kbball/runner-early-warning/hardware/ew-carrier/ew-carrier.kicad_sch

## KiCad design hardware/ew-carrier/ew-carrier.kicad_sch (2026-10-12)

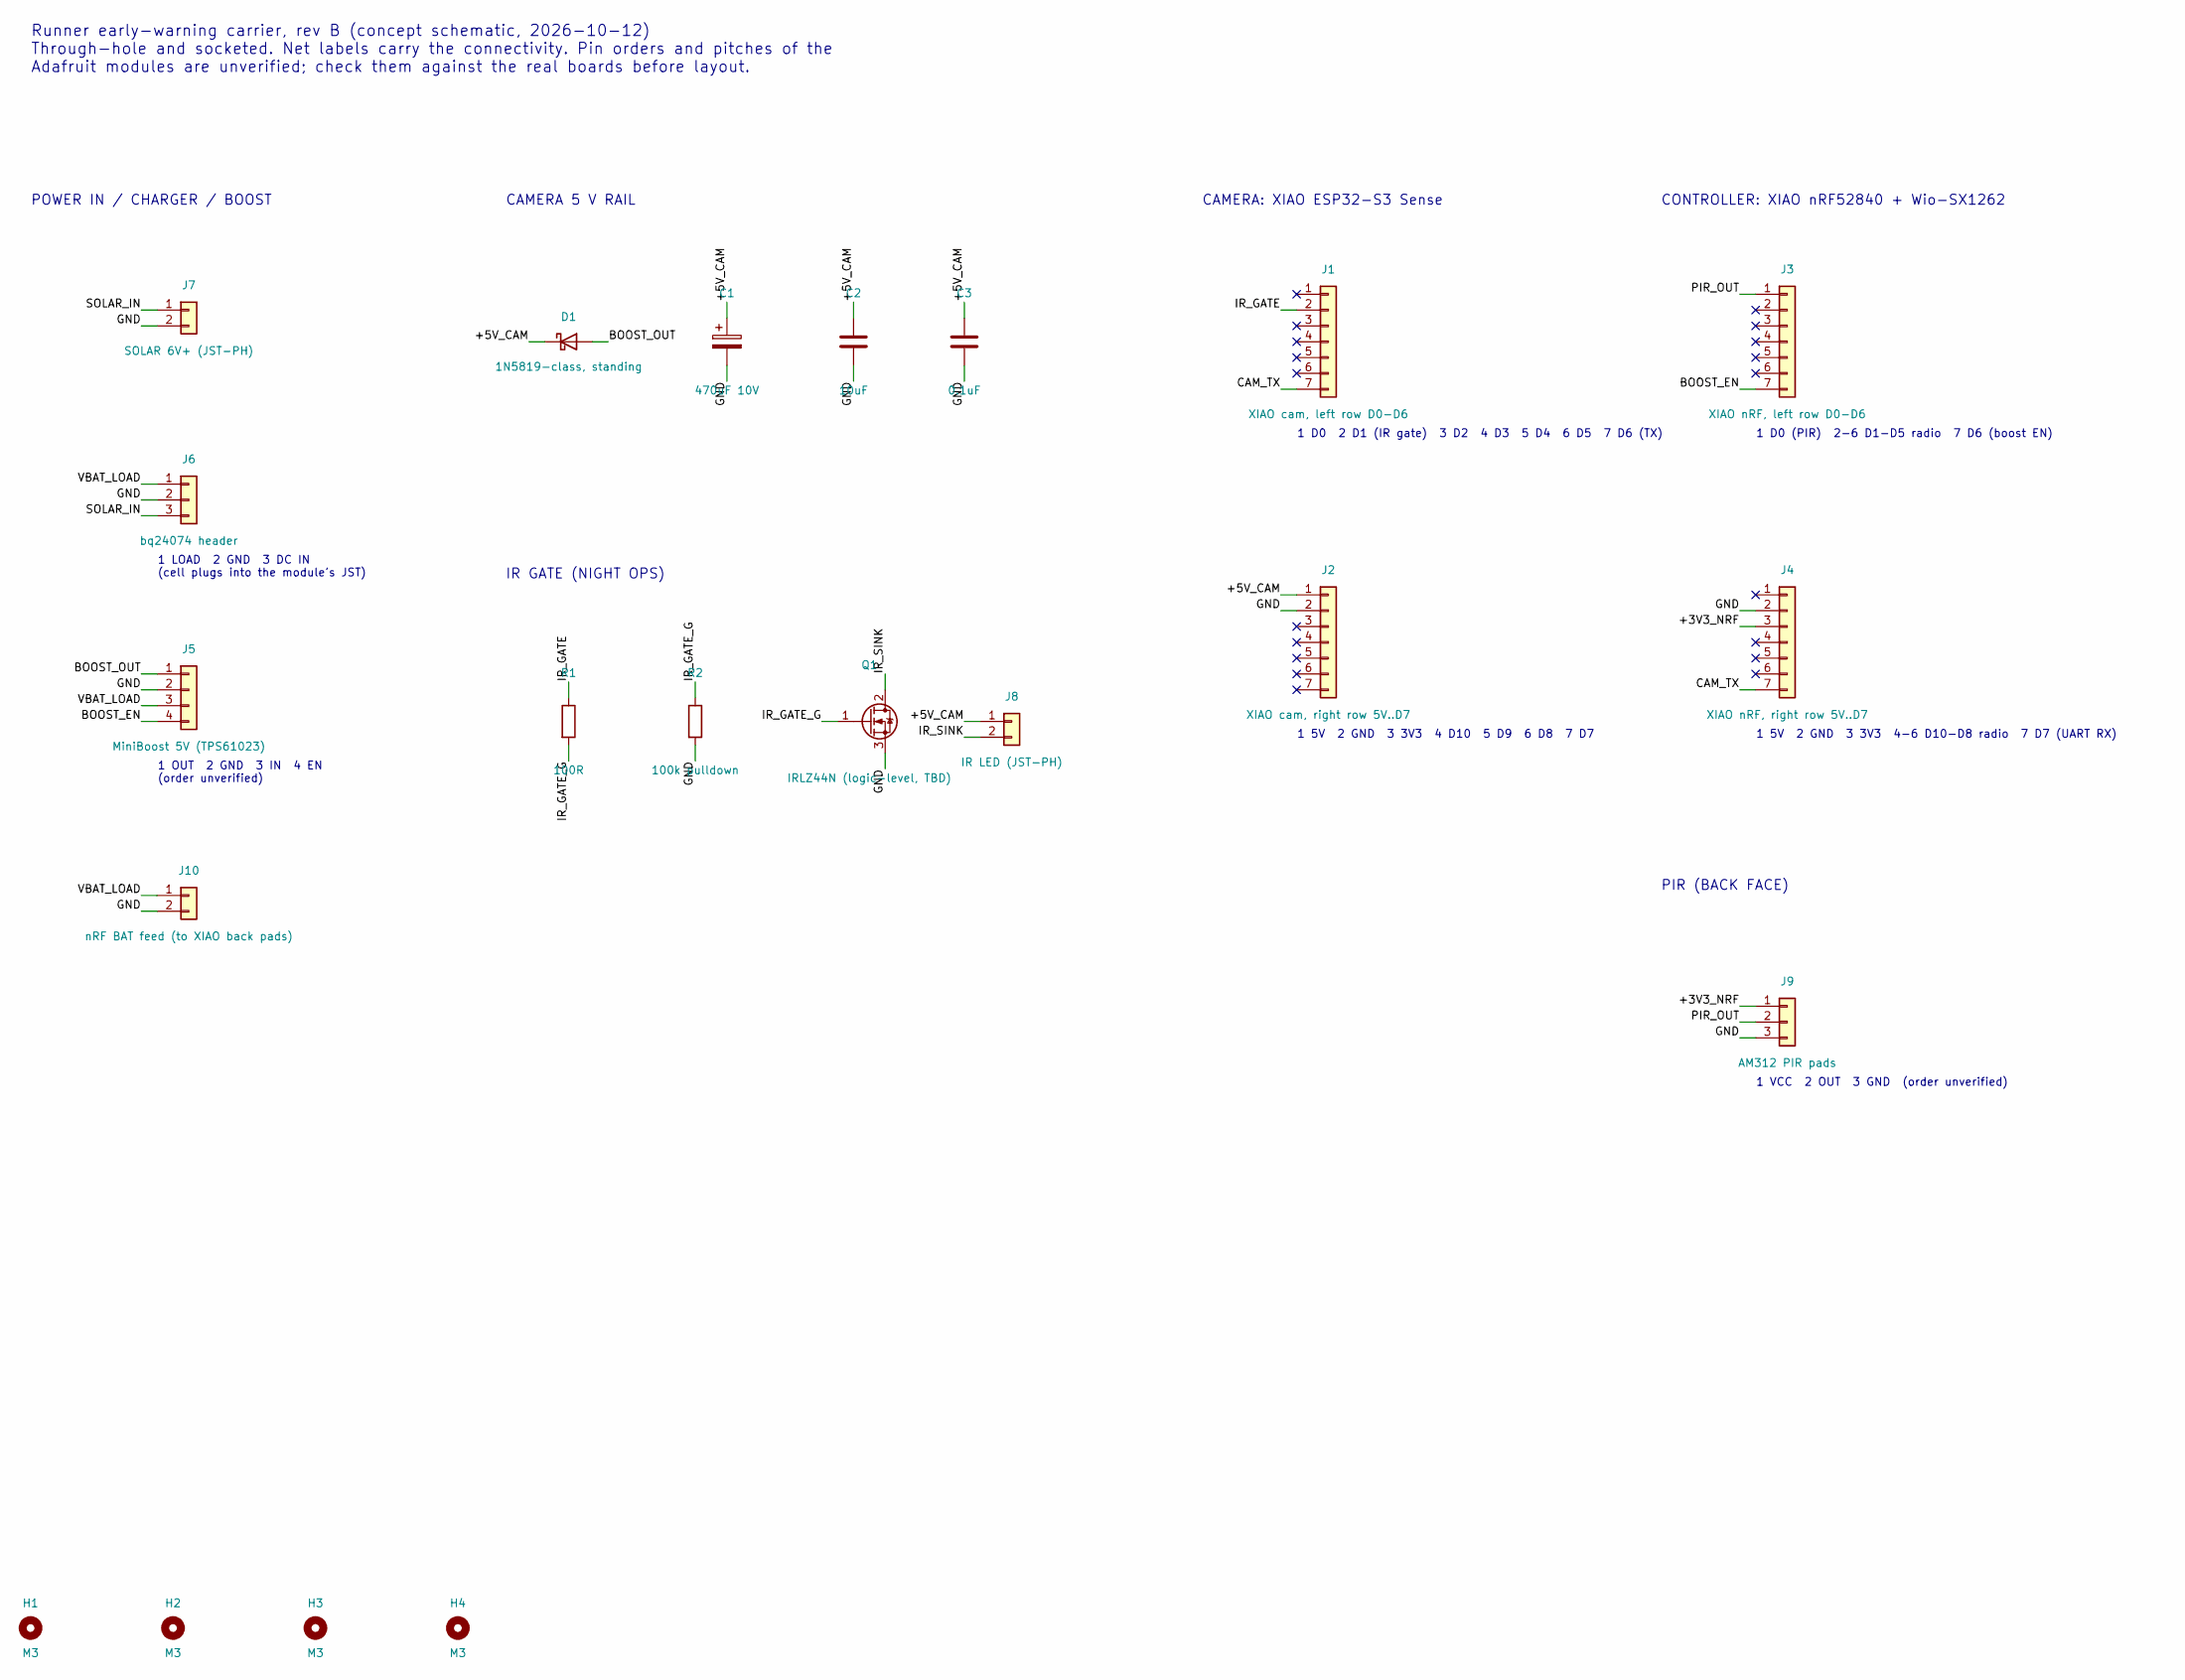
[picture p1: schematic ew-carrier.kicad_sch]

Parts:
C1: 470uF 10V; CP_Radial_D8.0mm_P3.50mm
C2: 10uF; C_Disc_D5.0mm_W2.5mm_P5.00mm
C3: 0.1uF; C_Disc_D5.0mm_W2.5mm_P5.00mm
D1: 1N5819-class, standing; D_DO-41_SOD81_P3.81mm_Vertical_CathodeUp
H1, H2, H3, H4: M3; MountingHole_3.2mm_M3
J1: XIAO cam, left row D0-D6; PinSocket_1x07_P2.54mm_Vertical
J2: XIAO cam, right row 5V..D7; PinSocket_1x07_P2.54mm_Vertical
J3: XIAO nRF, left row D0-D6; PinSocket_1x07_P2.54mm_Vertical
J4: XIAO nRF, right row 5V..D7; PinSocket_1x07_P2.54mm_Vertical
J5: MiniBoost 5V (TPS61023); PinSocket_1x04_P2.54mm_Vertical
J6: bq24074 header; PinSocket_1x03_P2.54mm_Vertical
J7: SOLAR 6V+ (JST-PH); JST_PH_B2B-PH-K_1x02_P2.00mm_Vertical
J8: IR LED (JST-PH); JST_PH_B2B-PH-K_1x02_P2.00mm_Vertical
J9: AM312 PIR pads; PinHeader_1x03_P2.54mm_Vertical
J10: nRF BAT feed (to XIAO back pads); PinHeader_1x02_P2.54mm_Vertical
Q1: IRLZ44N (logic-level, TBD); TO-220-3_Vertical
R1: 100R; R_Axial_DIN0207_L6.3mm_D2.5mm_P10.16mm_Horizontal
R2: 100k pulldown; R_Axial_DIN0207_L6.3mm_D2.5mm_P10.16mm_Horizontal

Connections:
+3V3_NRF: J4.3, J9.1
+5V_CAM: C1.1, C2.1, C3.1, D1.1 (K), J2.1, J8.1
BOOST_EN: J3.7, J5.4
BOOST_OUT: D1.2 (A), J5.1
CAM_TX: J1.7, J4.7
GND: C1.2, C2.2, C3.2, J2.2, J4.2, J5.2, J6.2, J7.2, J9.3, J10.2, Q1.3 (S), R2.2
IR_GATE: J1.2, R1.1
IR_GATE_G: Q1.1 (G), R1.2, R2.1
IR_SINK: J8.2, Q1.2 (D)
PIR_OUT: J3.1, J9.2
SOLAR_IN: J6.3, J7.1
VBAT_LOAD: J5.3, J6.1, J10.1

Notes on the sheet:
Runner early-warning carrier, rev B (concept schematic, 2026-10-12) Through-hole and socketed. Net labels carry the connectivity. Pin orders and pitches of the Adafruit modules are unverified; check them against the real boards before layout.
POWER IN / CHARGER / BOOST
1 LOAD 2 GND 3 DC IN (cell plugs into the module's JST)
1 OUT 2 GND 3 IN 4 EN (order unverified)
CAMERA 5 V RAIL
IR GATE (NIGHT OPS)
CAMERA: XIAO ESP32-S3 Sense
1 D0 2 D1 (IR gate) 3 D2 4 D3 5 D4 6 D5 7 D6 (TX)
1 5V 2 GND 3 3V3 4 D10 5 D9 6 D8 7 D7
CONTROLLER: XIAO nRF52840 + Wio-SX1262
1 D0 (PIR) 2-6 D1-D5 radio 7 D6 (boost EN)
1 5V 2 GND 3 3V3 4-6 D10-D8 radio 7 D7 (UART RX)
PIR (BACK FACE)
1 VCC 2 OUT 3 GND (order unverified)
