kbball/runner-early-warning/(commit log)

2026-10-12 Initial commit: firmware README and rev B carrier KiCad schematic
    [ew-carrier.kicad_sch]
2026-10-12 PIR node firmware: trigger and heartbeat beacons over BLE advertising
    Adds the pir-node PlatformIO project (XIAO nRF52840), a shared TriggerPacket
    library with host unit tests, and the board definition it needs.
2026-10-12 Trigger board firmware, shared logic with host tests, shared XIAO board support
    trigger-node scans for the PIR node's BLE packets, raises the camera boost EN on a
    new trigger group, reads the camera's UART lines and logs to USB serial.
    TriggerLogic (packet groups, enable window) and CameraMsg (UART parser) are host
    unit tested (28 tests). The XIAO nRF52840 board definition moves to common/ so both
    nRF projects share it.
2026-10-12 Point board-support notes at common/xiao_nrf52840
2026-10-13 Trigger board: record first flash and link check with the PIR node
2026-10-13 Camera node firmware (stub detector), MeshCore frame builder, UART line formatter
    camera-node: XIAO ESP32-S3 Sense firmware that reports on its UART at boot, grabs frames
    for a session, sends a verdict and DONE, then sleeps. The detector is a stub.
    common: MeshCoreFrames builds companion-protocol frames; CameraMsg gains a formatter
    that round-trips with the parser. 36 host tests pass.
2026-10-13 README: PIR node and trigger board status
2026-10-13 License under GPL-3.0-or-later; record third-party licenses
    Adds LICENSE (GPL-3.0), NOTICE.md (what is included or built against, each license, and
    why it does not conflict), SPDX headers on first-party source, and a README license
    section. The MeshCore board runs firmware from the MeshCore fork, noted in the README.
2026-10-13 camera-node: bench Wi-Fi live viewer env; share camera config in a header
    Adds env camera_view (bench/view.cpp): the board becomes a Wi-Fi AP serving
    an MJPEG view at http://192.168.4.1/ for checking focus, aim and exposure.
    Camera pins and sensor settings move to include/CameraConfig.h so the node
    firmware and the viewer share them.
2026-10-13 camera-node: port to ESP-IDF, person detection with ESP-DL, setup mode
    Moves the camera node from Arduino to plain ESP-IDF (PlatformIO espidf, 5.4)
    because ESP-DL needs IDF 5.3+. Detection is Espressif's pedestrian model
    (PICO_S8_V1), loaded from its own flash partition and flashed by
    model_partition.py; PlatformIO cannot run the component's embed step, and
    its bundled CMake is too old, so tool-cmake 3.30.2 is pinned.
    Setup mode (D1 high at power-up, or the camera_view env) serves a Wi-Fi
    access point with a live view, detection boxes, a settings form saved in NVS
    (threshold, frames in a row, session length) and a log of recent sessions.
    Dropped: the Arduino build, the microSD frame saving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
    [partitions.csv]
2026-10-13 Breadboard page: add the MeshCore stack to the camera node rig
2026-10-13 Breadboard page: MeshCore stack carries the L76K; camera UART goes to D0, not D7
